ramesh424/Water-Meter-Retrofit/Validation/image5.png

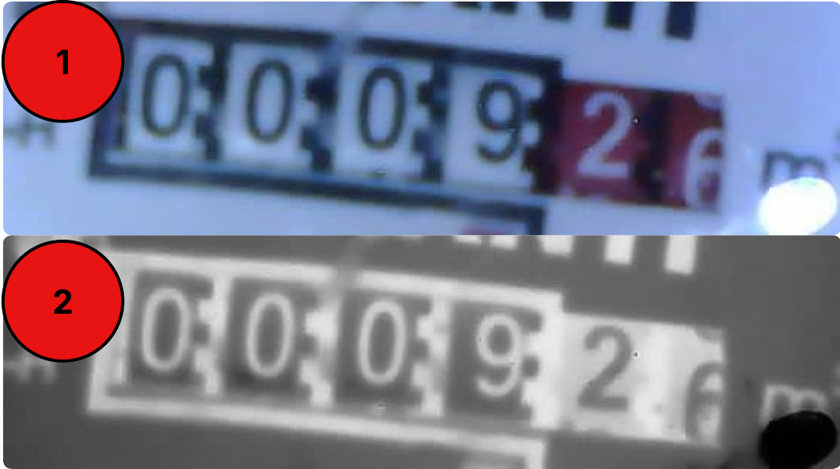
Validation/image5.png
