ramesh424/Water-Meter-Retrofit/Validation/image2.jpeg

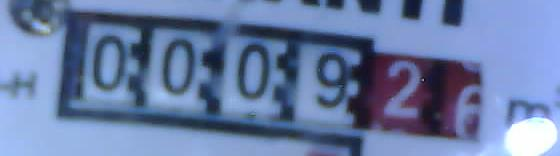
Validation/image2.jpeg
