ramesh424/Water-Meter-Retrofit/electronics/schematic/pcb.png

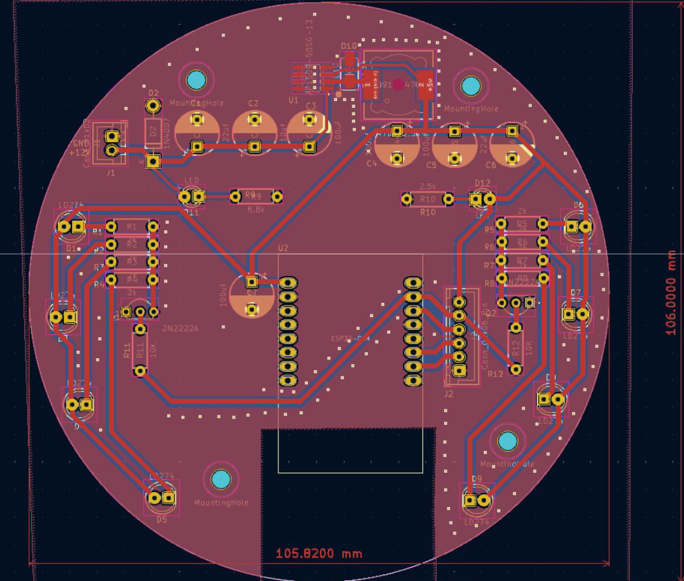
electronics/schematic/pcb.png
