ramesh424/Water-Meter-Retrofit/Mechinical files/Assembly model (1).PDF

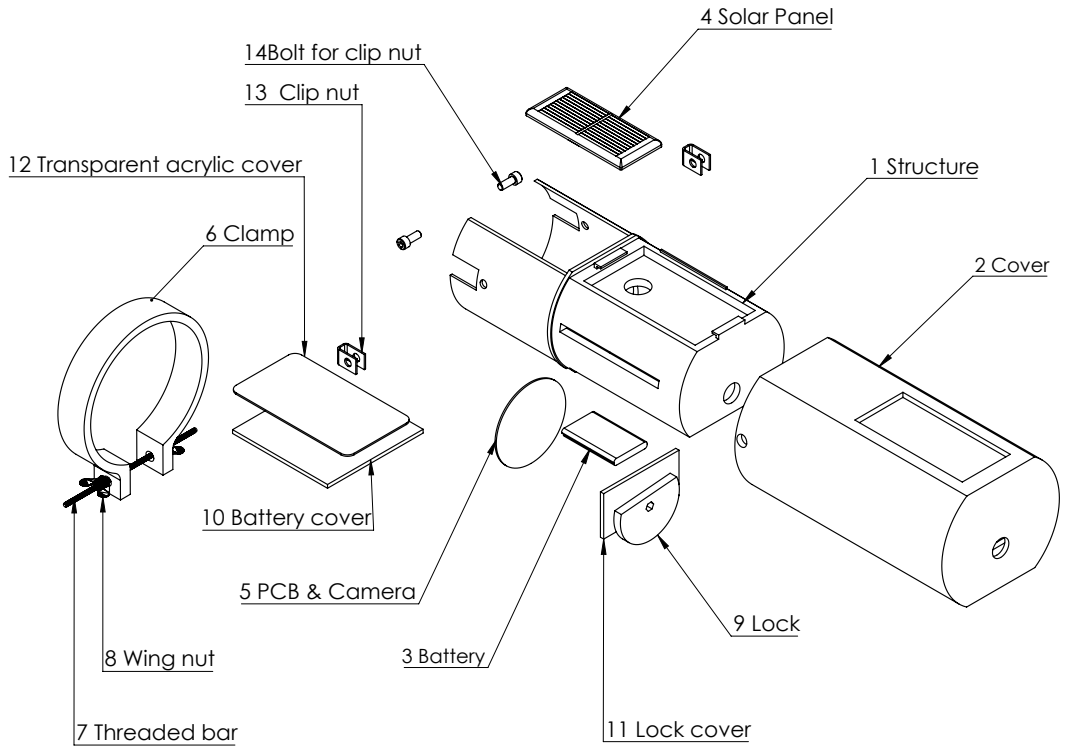
[picture p4: page 1]
1 Structure; 2 Cover; 3 Battery; 4 Solar Panel; 5 PCB & Camera; 6 Clamp; 7 Threaded bar; 8 Wing nut; 9 Lock; 10 Battery cover; 11 Lock cover

14Bolt for clip nut
13 Clip nut

12 Transparent acrylic cover
