ramesh424/Water-Meter-Retrofit/Mechinical files/Measurements.PDF

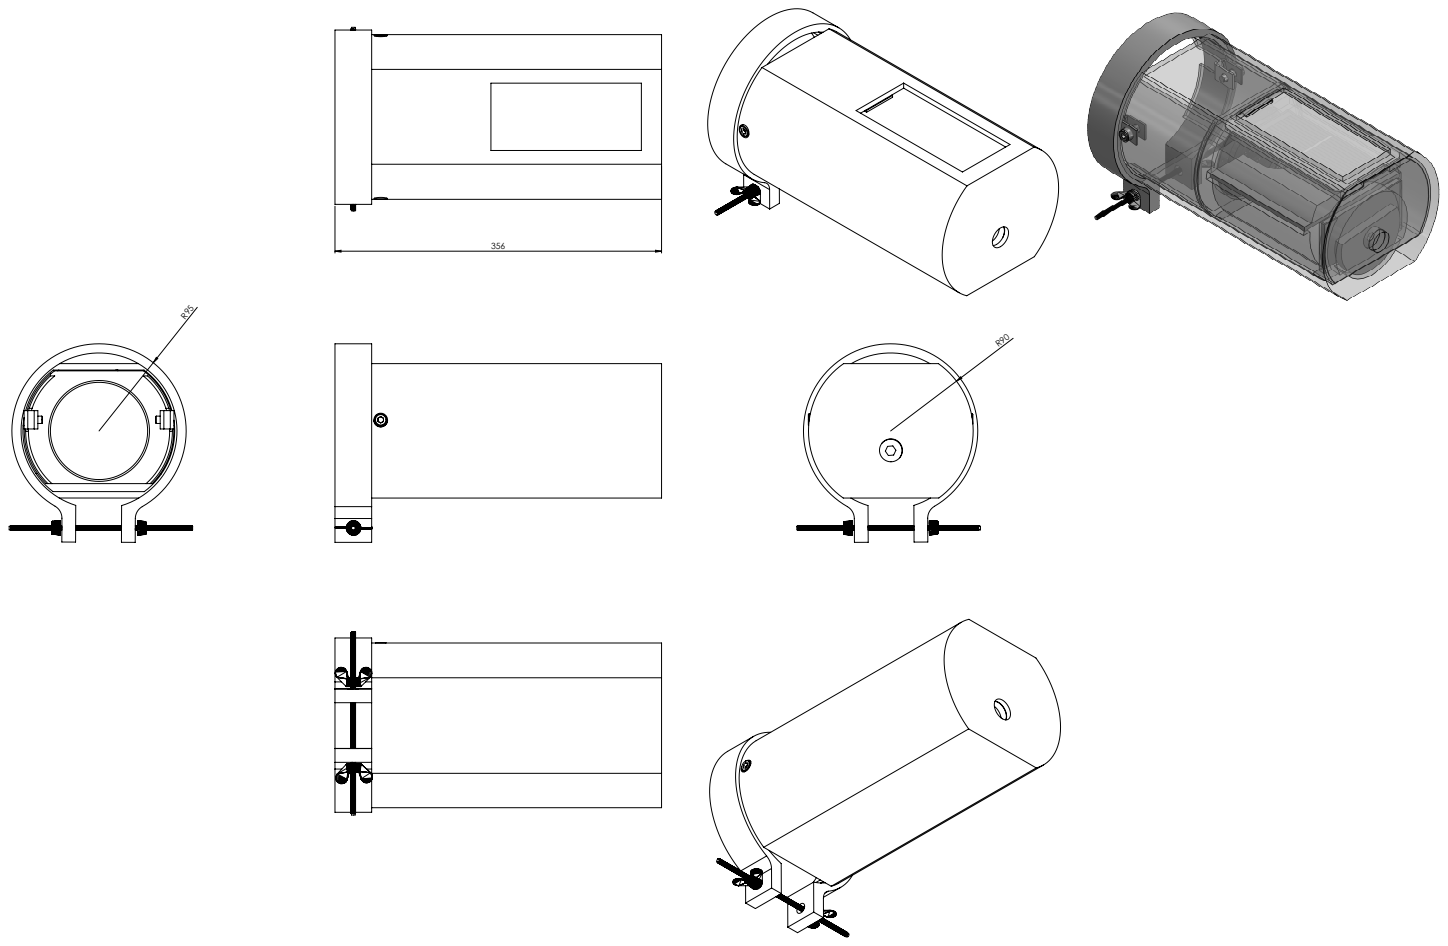
[picture p5: page 1]
