ramesh424/Water-Meter-Retrofit/electronics/schematic/PCB_Circuit_Design_of_the_Water_Meter.pdf

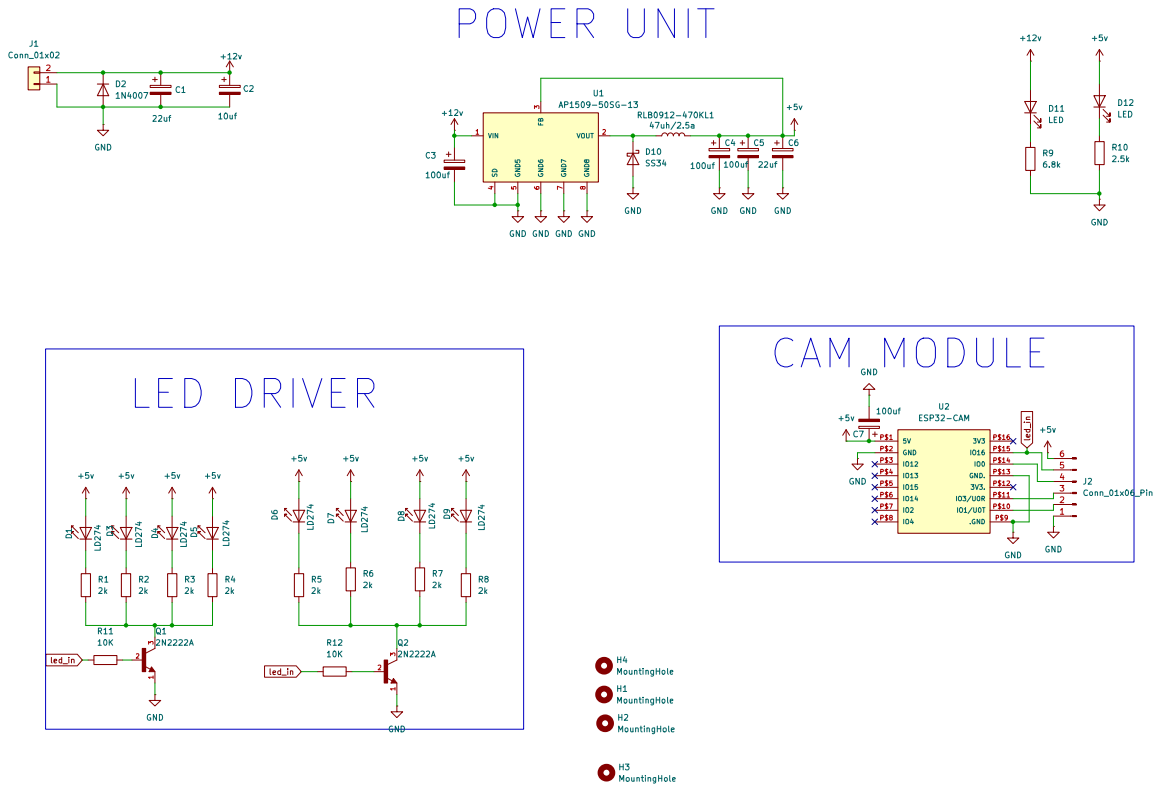
[picture p6: page 1]
