ramesh424/Water-Meter-Retrofit/Mechinical files/labels.PDF

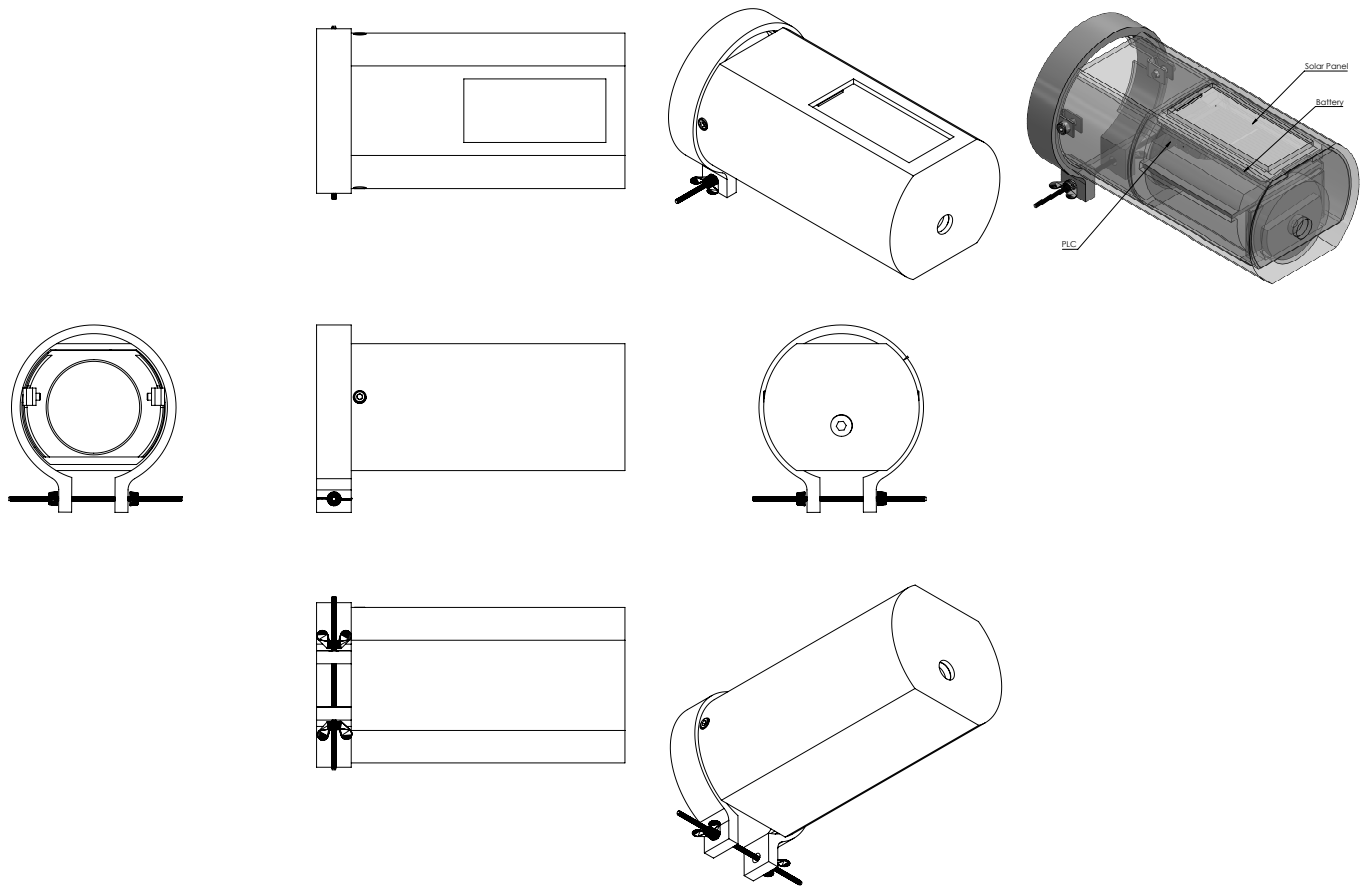
[picture p7: page 1]
Solar Panel
