ramesh424/Water-Meter-Retrofit/Validation/image6.png

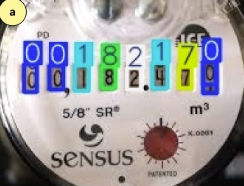
Validation/image6.png
