ramesh424/Water-Meter-Retrofit/(commit log)

2026-05-05 Rename espcamv1kk (1).zip to electronics/schematic/Gerber files zip
2026-05-05 Rename Print 3d 23.5.25.zip to Mechinical files/cad files
2026-05-05 Rename Assembly model.PDF to Mechnical files/cad files
2026-05-05 Rename BOM.csv to bill of materials/BOM.csv
    [BOM.csv]
2026-05-05 Rename BOM.xlsx to bill of materials/BOM.xlsx
    [BOM.xlsx]
2026-05-21 Rename BOM (Bill of Materials).csv to Bill of Materials/BOM (Bill of Materials).csv
    [BOM (Bill of Materials).csv]
